AlexYFM/FA22-ECE445-Hearing-Alarm/notebooks/alex/media/IMG_20221106_111339.jpg

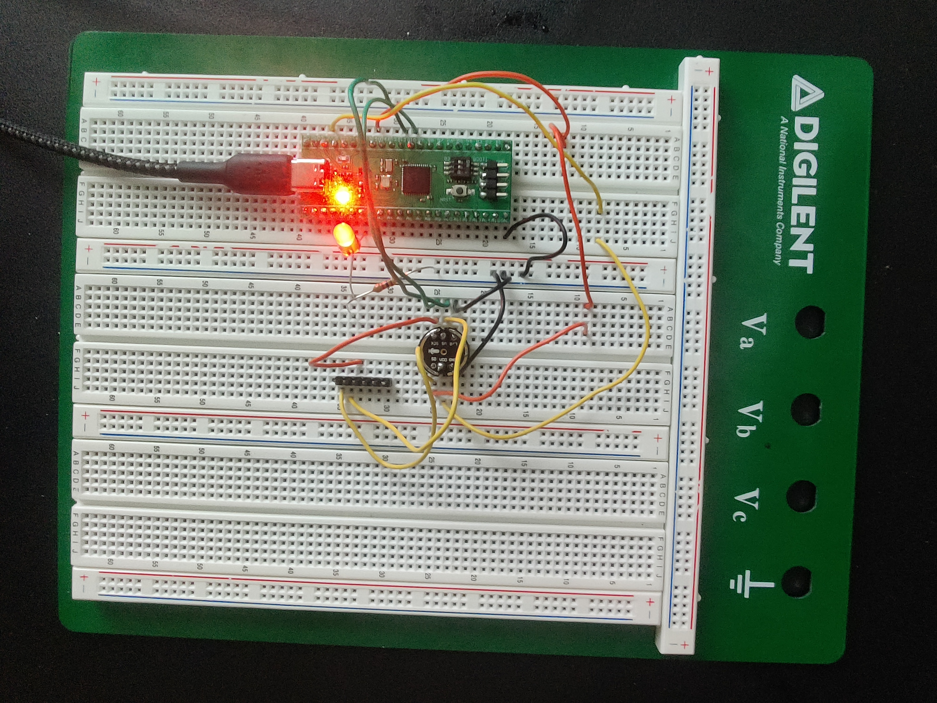
notebooks/alex/media/IMG_20221106_111339.jpg
