AlexYFM/FA22-ECE445-Hearing-Alarm/README.md

# FA22-ECE445 HEARING DAMAGE DETECTOR AND ALARM SYSTEM
* Alex Yuan (ayuan20)
* Jinzhi Shen (jinzhis2)
* Jake Fava (jfava2)
