AlexYFM/FA22-ECE445-Hearing-Alarm/important docs/README.md

# Directory to store important documents like design doc, pcb design, etc.
