AlexYFM/FA22-ECE445-Hearing-Alarm/notebooks/alex/Final Figures 09_29.pdf

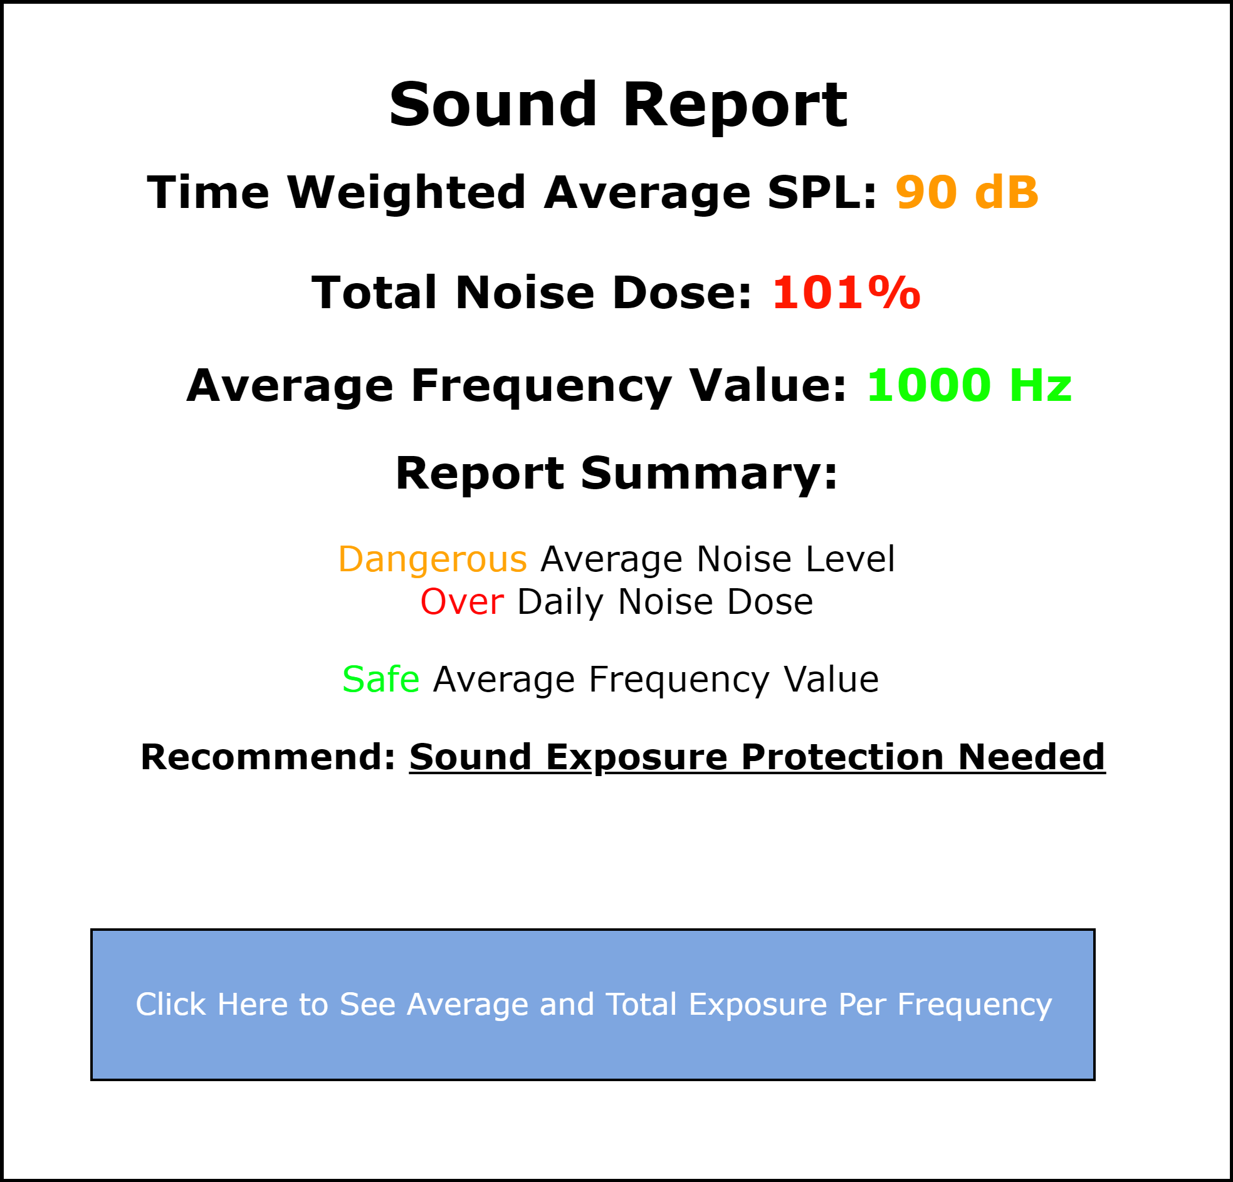
[picture p5: figure]

Sample UI

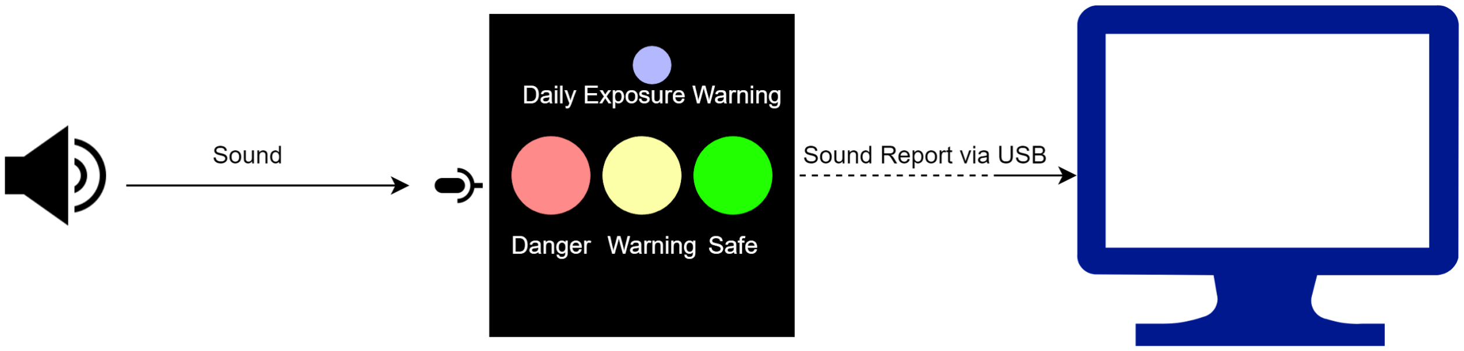
[picture p6: figure]

Visual Aid

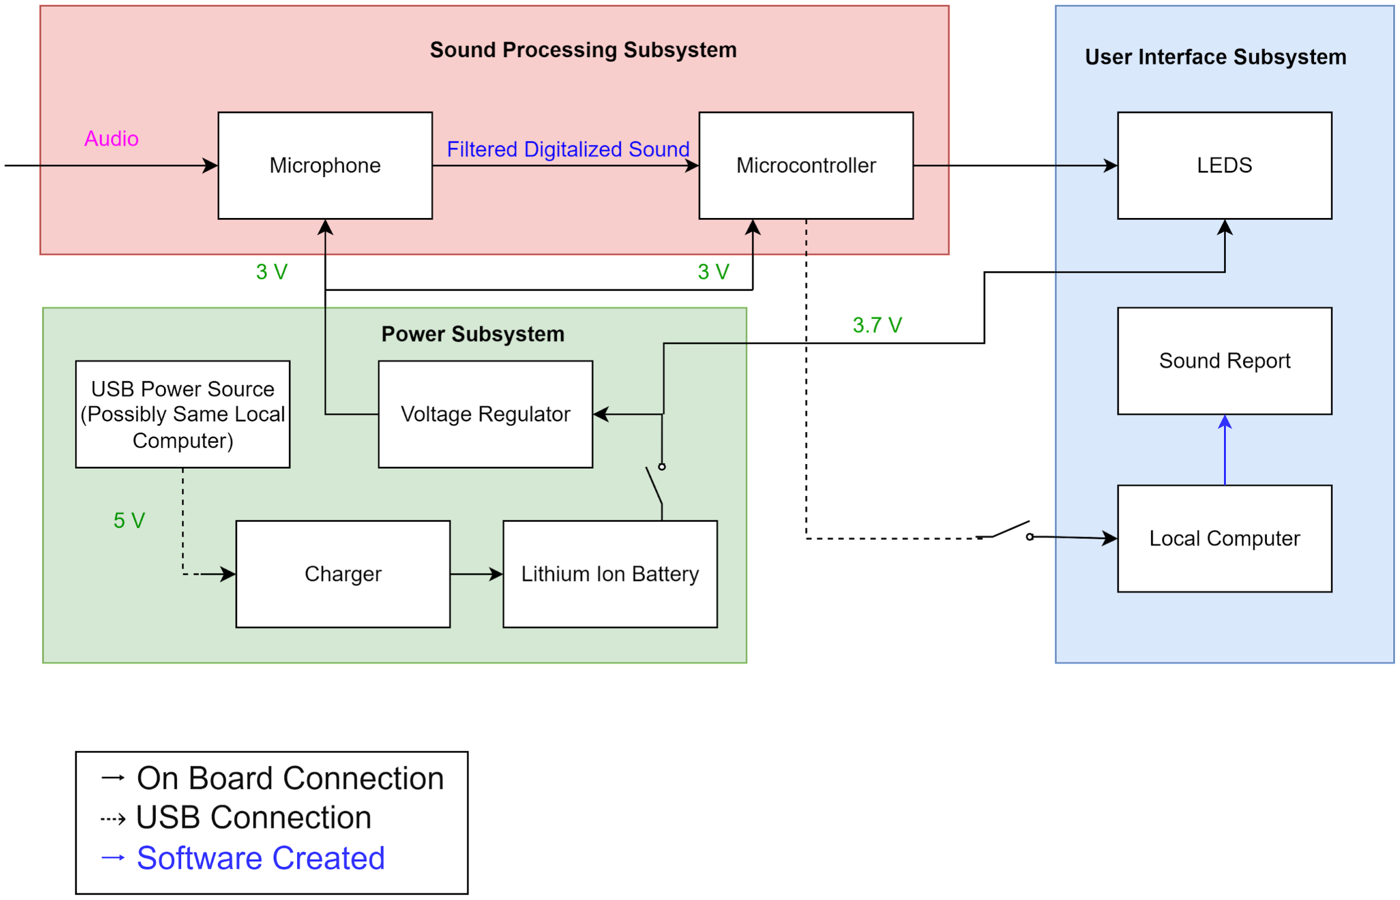
[picture p7: figure]

Subsystem Block Diagram
