AlexYFM/FA22-ECE445-Hearing-Alarm/notebooks/alex/Design Doc Final Bibliography 09-29.txt

[1] J. J. Eggermont, “Effects of long-term non-traumatic noise exposure on the adult central auditory system. hearing problems without hearing loss,” Hearing Research, vol. 352, pp. 12–22, 2017.
[2] V. P. of A. E. and M. C. at C. U. I. D. Jeff Smoot, “A comparison of digital PDM and I²S interfaces in MEMS microphones,” Digi, 11-Jul-2022. [Online]. Available: https://www.digikey.com/en/articles/a-comparison-of-digital-pdm-and-i2s-interfaces-in-mems-microphones. [Accessed: 29-Sep-2022]. 

[3] “AN5027 application note - stmicroelectronics.” [Online]. Available: https://www.st.com/resource/en/application_note/an5027-interfacing-pdm-digital-microphones-using-stm32-mcus-and-mpus-stmicroelectronics.pdf. [Accessed: 29-Sep-2022]. 

[4] D. Ramsay, “How to get i2s working on an STM32 MCU,” Medium, 17-Feb-2018. [Online]. Available: https://medium.com/@davidramsay/how-to-get-i2s-working-on-an-stm32-mcu-33de0e9c9ff8. [Accessed: 29-Sep-2022]. 
[5] “Department of Labor Logo United Statesdepartment of Labor,” Occupational Noise Exposure - Overview | Occupational Safety and Health Administration. [Online]. Available: https://www.osha.gov/noise. [Accessed: 24-Sep-2022]. 
[6] St Community. [Online]. Available: https://community.st.com/s/question/0D50X00009XkYmFSAV/logarithm-and-exponential-function. [Accessed: 29-Sep-2022]. 
[7] “Noise dosimetry terminology,” Larson Davis. [Online]. Available: http://www.larsondavis.com/learn/industrial-hygiene/noise-dosimetry-terminology. [Accessed: 13-Sep-2022]. 
[8] “A-weighting table,” Acoustical Engineer. [Online]. Available: https://acousticalengineer.com/a-weighting-table/. [Accessed: 29-Sep-2022]. 
[9] “Department of Labor Logo United Statesdepartment of Labor,” 1910.95 App A - Noise Exposure Computation | Occupational Safety and Health Administration. [Online]. Available: https://www.osha.gov/laws-regs/regulations/standardnumber/1910/1910.95AppA#:~:text=If%20the%20dose%20as%20read,accumulated%20dose%20in%20percent%20exposure. [Accessed: 28-Sep-2022]. 
[10] Grainger Engineering Office of Marketing and Communications, “Salary averages,” Electrical &amp; Computer Engineering | UIUC. [Online]. Available: https://ece.illinois.edu/admissions/why-ece/salary-averages. [Accessed: 22-Sep-2022]. 
[11] E. Boehning, G. Chan, and J. Huh, “UV Sensor and Alert System for Skin Protection (Design Document),” 05-Mar-2022. [Online]. Available: https://courses.engr.illinois.edu/ece445/getfile.asp?id=20032. [Accessed: 22-Sep-2022]. 
[12] “IEEE code of Ethics,” IEEE. [Online]. Available: https://www.ieee.org/about/corporate/governance/p7-8.html. [Accessed: 13-Sep-2022].
