AlexYFM/FA22-ECE445-Hearing-Alarm/notebooks/alex/media/better.png

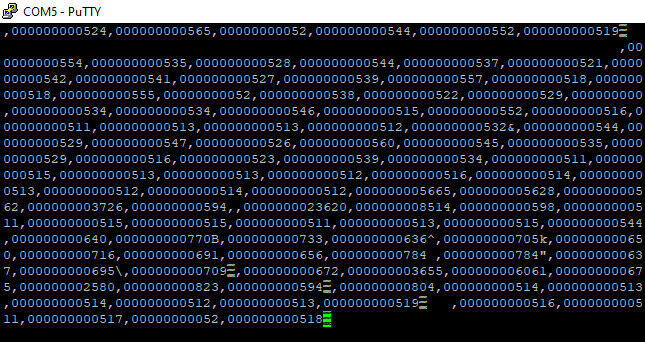
notebooks/alex/media/better.png
