AlexYFM/FA22-ECE445-Hearing-Alarm/notebooks/alex/media/pcb 10_26.png

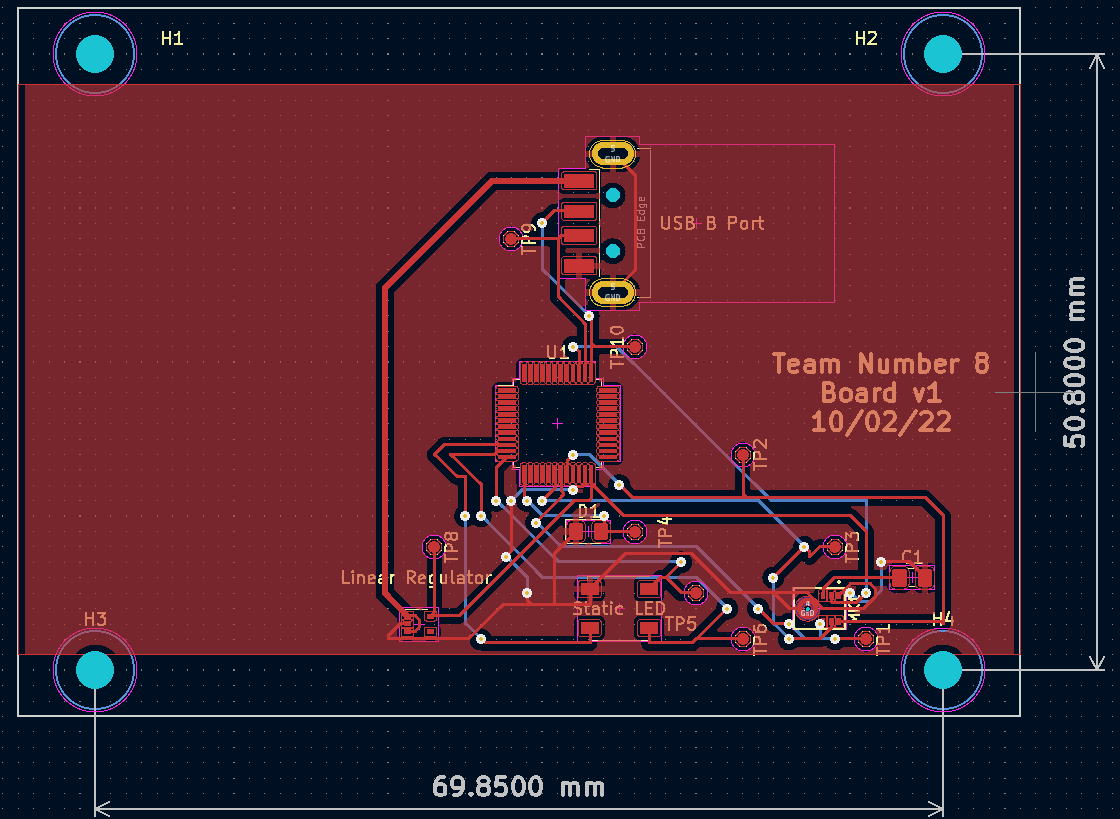
notebooks/alex/media/pcb 10_26.png
