AlexYFM/FA22-ECE445-Hearing-Alarm/notebooks/alex/media/schematic 10_26.png

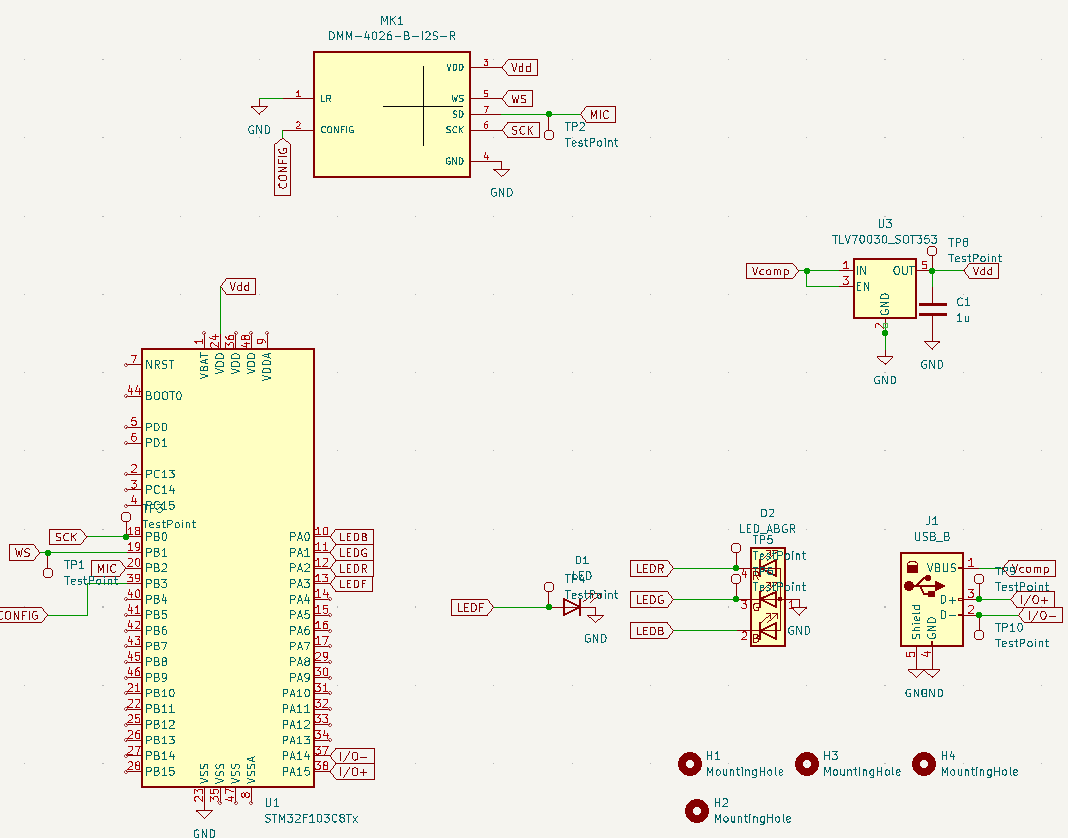
notebooks/alex/media/schematic 10_26.png
