AlexYFM/FA22-ECE445-Hearing-Alarm/code/dev/Core/Src/main.c

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
/* Includes ------------------------------------------------------------------*/
#define __FPU_PRESENT             1U
#define ARM_MATH_CM4
#include "arm_math.h"
#include "main.h"
#include "usb_device.h"

/* USER CODE BEGIN Includes */
#include "usbd_cdc_if.h"
#include "string.h"
#include <math.h>
//#include "arm_math.h"
/* USER CODE END Includes */

/* USER CODE BEGIN PD */
#define interval 0.5 //the time interval per sample
//#define ARM_MATH_CM4
/* USER CODE END PD */

I2S_HandleTypeDef hi2s2;

void SystemClock_Config(void);
static void MX_GPIO_Init(void);
static void MX_I2S2_Init(void);
/* USER CODE BEGIN PFP */
void toStr(uint16_t d, char* str);
void getStr(int32_t d, char* str);
double dailyDose(int32_t p);
/* USER CODE END PFP */

/* USER CODE BEGIN 0 */
uint8_t buffer[64];
uint8_t *data;
/*
	  HAL_GPIO_TogglePin (GPIOA, LED_Pin);
	  while(count){
		  volatile HAL_StatusTypeDef result = HAL_I2S_Receive(&hi2s2, data_in, 2, 100);
		  if (result == HAL_OK) {
			  if(data_in[1]==0||data_in[0]>=16384) continue;
			  current = data_in[0]+(data_in[1]>>7);
			  samples[--count] = current;
		  }
	  }
	  for (int i=0; i<n; i++){
		  davg += samples[i]/n; //average
	  }
	  avg = (int32_t) davg;
	  for (int i=0; i<n; i++){
		  samples[i] -= avg;
		  if(min>samples[i]) min = samples[i];
		  if(max<samples[i]) max = samples[i];
	  }
	  count = n;
	  peak = max-min;
	  max = 0;
	  min = 100000;
	  getStr(peak, s); //2072.43028737 -- 90 dB right shifted by 7
	  davg = 0;
	  data = s;
	  CDC_Transmit_FS(data, strlen(data));
	  HAL_Delay(500);
*/
/* USER CODE END 0 */

/**
  * @brief  The application entry point.
  * @retval int
  */
int main(void)
{
  /* MCU Configuration--------------------------------------------------------*/

  /* Reset of all peripherals, Initializes the Flash interface and the Systick. */
  HAL_Init();

  /* Configure the system clock */
  SystemClock_Config();

  /* Initialize all configured peripherals */
  MX_GPIO_Init();
  MX_I2S2_Init();
  MX_USB_DEVICE_Init();
  /* USER CODE BEGIN 2 */
  uint16_t data_in[2];
  uint16_t n = 256; //number of samples, keep at power of 2 for FFT
  int32_t current;
  uint16_t count = n;
  int32_t avg = 0; //running average of the sampled data
//  int32_t min_avg = -1; //keeps track of the lowest average so far -- DC offset
  uint8_t s[7]; //store string output
  s[6] = '\0'; //null character to terminate the string -- this should remove any weird artifacts
  float davg=0;
  double dd = 0; //keep track of daily dose
  int reached = 16; //simple counter
  int dd_reached = 0; //keep track of if we've reached dd threshold
  int duration = 0;
  int32_t max_peak;
  int32_t decibel;
  int32_t max = 0;
  int32_t min = 100000;
  int32_t peak = 0;
  int32_t samples[n];

  //arm code below from https://stm32f4-discovery.net/2014/10/stm32f4-fft-example/
//  arm_cfft_radix4_instance_f32 S;	/* ARM CFFT module */
//  float32_t maxValue;				/* Max FFT value is stored here */
//  uint32_t maxIndex;				/* Index in Output array where max value is */
//  float32_t fft_output[n];
//  float32_t fft_input[2*n];
  /* USER CODE END 2 */
  /* Infinite loop */
  /* USER CODE BEGIN WHILE */
  while (1)
  {
	  while(count){
		  volatile HAL_StatusTypeDef result = HAL_I2S_Receive(&hi2s2, data_in, 2, 100);
		  if (result == HAL_OK) {
			  if(data_in[1]==0||data_in[0]>=32768) continue; //need this otherwise data is way too noisy
			  //trying without any checks for zeros or potential negatives
			  current = data_in[0];
			  samples[--count] = current;
		  }
	  }
	  for (int i=0; i<n; i++){
		  davg += samples[i]/n; //average
	  }
	  avg = (int32_t) davg;
	  for (int i=0; i<n; i++){
		  samples[i] -= avg;
		  if(min>samples[i]) min = samples[i];
		  if(max<samples[i]) max = samples[i];
	  }
	  count = n;
	  peak = max-min;
	  max = 0;
	  min = 100000;
	  davg = 0;
	  data = s;
	  dd += dailyDose(peak);
	  if(peak>2072){
		  HAL_GPIO_WritePin(GPIOA, LEDINST_Pin, GPIO_PIN_SET); //If over given value, means >90 dB, set warning
		  duration = 8; //adding minimum duration of 8 cycles
	  }
	  else if(duration<=0) HAL_GPIO_WritePin(GPIOA, LEDINST_Pin, GPIO_PIN_RESET); //duration over -- "loud" noise not detected any longer
	  else duration--; //duration not over but not updated -- decrease duration

	  if(dd>=1&&dd_reached==0){
		  HAL_GPIO_TogglePin(GPIOA, LEDINT_Pin); //If we've reached daily dose
		  dd_reached = 1; //Making sure we don't keep toggling pin
	  }
	  if(peak>max_peak) max_peak = peak;
	  reached--;
	  if(!reached){
//		  for(int i=0; i<2*n; i+=2){ //this code from same arm source as above
//			  fft_input[i] = samples[i]; //real
//			  fft_input[i+1] = 0; //imaginary
//		  }
//		  arm_cfft_radix4_init_f32(&S, n, 0, 1);
//	      arm_cfft_radix4_f32(&S, fft_input);
//	      arm_cmplx_mag_f32(fft_input, fft_output, n);
////	      arm_max_f32(fft_output, n, &maxValue, &maxIndex); //this code computes fft and computes the maximum index and maximum value
//	      maxIndex = 0;
//	      maxValue = fft_output[0];
//	      for(int i=1; i<n; i++){
//	    	  if(fft_output[i]>maxValue){
//	    		  maxValue = fft_output[i];
//	    		  maxIndex = i;
//	    	  }
//	      }

		  HAL_GPIO_TogglePin(GPIOA, LED_Pin);
		  reached = 16;
//		  getStr(max_peak, s); //2072.43028737 -- around 70-80 dB right shifted by 7
//		  CDC_Transmit_FS(data, strlen(data));
		  decibel = (int)(10.0*(log(max_peak/2072.0)/log(2.0)))+70; //if peak is too low, maybe modify it by downshifting more/applying a function to account for noise
		  if(decibel<0) decibel = 0; //negative decibel values both don't make sense and make weird USB outputs
		  getStr(decibel, s);
		  max_peak = 0; //reset max peak
		  data = s;
		  HAL_Delay(50); //allow the USB transfer to reset, code similar to this did weird stuff without it
		  CDC_Transmit_FS(data, strlen(data));
//		  getStr((int32_t) maxIndex, s);
//		  data = s;
//		  HAL_Delay(50); //allow the USB transfer to reset, code similar to this did weird stuff without it
//		  CDC_Transmit_FS(data, strlen(data));
	  }
  }
    /* USER CODE END WHILE */

}

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
/* USER CODE BEGIN 4 */
void toStr(uint16_t d, char* str){ //converting int16_t to decimal -- assuming positive, which isn't always true
	str[4]=d%10+'0';
	d/=10;
	str[3]=d%10+'0';
	d/=10;
	str[2]=d%10+'0';
	d/=10;
	str[1]=d%10+'0';
	d/=10;
	str[0]=d%10+'0';
}

void getStr(int32_t d, char* str){ //assume str's length is at least 10
	uint8_t count = 5;
	while(count){
		str[--count] = d%10+'0'; //there's an easier way to do this, but don't want to waste memory
		d/=10;
	}
	str[5] = ',';
}

double dailyDose(int32_t p){ //adapted from my python code
	double arg = (double) (p)/ 2072; //Using current definition of 90 dB, may change later -- make into a macro
	arg = 10*log(p)/log(10); // to compute dB version of p using 90 dB as a reference
	arg = pow(2, -arg/5);
	double t = 8*60*60*arg; //defining the resulting exposure time period
	return interval/t; //finally, return how much this exposure contributed to the daily dose based on
}
/* USER CODE END 4 */
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
