AlexYFM/FA22-ECE445-Hearing-Alarm/code/dev/Core/Inc/main.h

#define LED_Pin GPIO_PIN_1
#define LED_GPIO_Port GPIOA
#define LEDINST_Pin GPIO_PIN_3
#define LEDINST_GPIO_Port GPIOA
#define LEDINT_Pin GPIO_PIN_5
#define LEDINT_GPIO_Port GPIOA
