AlexYFM/FA22-ECE445-Hearing-Alarm/(commit log)

2022-11-06 First half working version to read I2S input.
    First version of main.c that I got to sort of work with the I2S input and give a reasonable, but still wrong, I2S output. The problem right now is the offset that makes the values I'm getting magnitudes off.
    [main.c]
2022-11-08 Updated main.c
    After meeting Sunday with the group, I made some changes to the code to make it hopefully run a little better -- instead of taking the average, the code now collects some samples, subtracts the average from all the samples, and "prints" the peak (max-min) value to the USB port.
2022-11-16 Better functionality for USB printout and decibel readings -- now s has a null character at the end to hopefully get rid of all artifacts
2022-11-16 Added video with only decibel and board, no absolute I2S readings
