AlexYFM/FA22-ECE445-Hearing-Alarm/(notices)

Notices in the files:
code/dev/Core/Inc/main.h:
Copyright (c) 2022 STMicroelectronics.
All rights reserved.
This software is licensed under terms that can be found in the LICENSE file
